johnlenfr/MicroView-RC/GITHUB_METADATA.md

# Recommended GitHub Repository Metadata

## Repository description

Open-source DIY Arduino-compatible RC transmitter/receiver using MicroView/ATmega328P, ATtiny85 and nRF24L01+ for drones, cars, boats, airplanes and robots.

## Recommended GitHub Topics

`arduino` `remote-control` `radio-control` `rc` `rc-transmitter` `rc-receiver`
`nrf24l01` `rf24` `atmega328p` `attiny85` `microview`
`diy-electronics` `embedded-systems` `telemetry` `robotics`
`drone` `rc-car` `rc-boat` `rc-airplane` `open-source`

## Related terms kept in documentation

`esp32` `stm32` `rp2040` `raspberry-pi-pico`

These are useful adaptation/search terms, but the current firmware is not a drop-in build for those platforms.
