johnlenfr/MicroView-RC/(commit log)

2026-09-25 Add PCB Gerber files for MicroView RC
    Adds the Gerber fabrication files for the current MicroView RC PCB revision.
2026-09-25 Add PCB Gerber files for MicroView RC v4.1.18
    Add PCB Gerber files for MicroView RC v4.1.18
2026-10-03 Add PCB overview image to README
    Add PCB overview image to README with white background and fix hardware file references
2026-10-10 False PCB
    False PCB
